wirano/haptic-knob/Model/LCD_TP.png

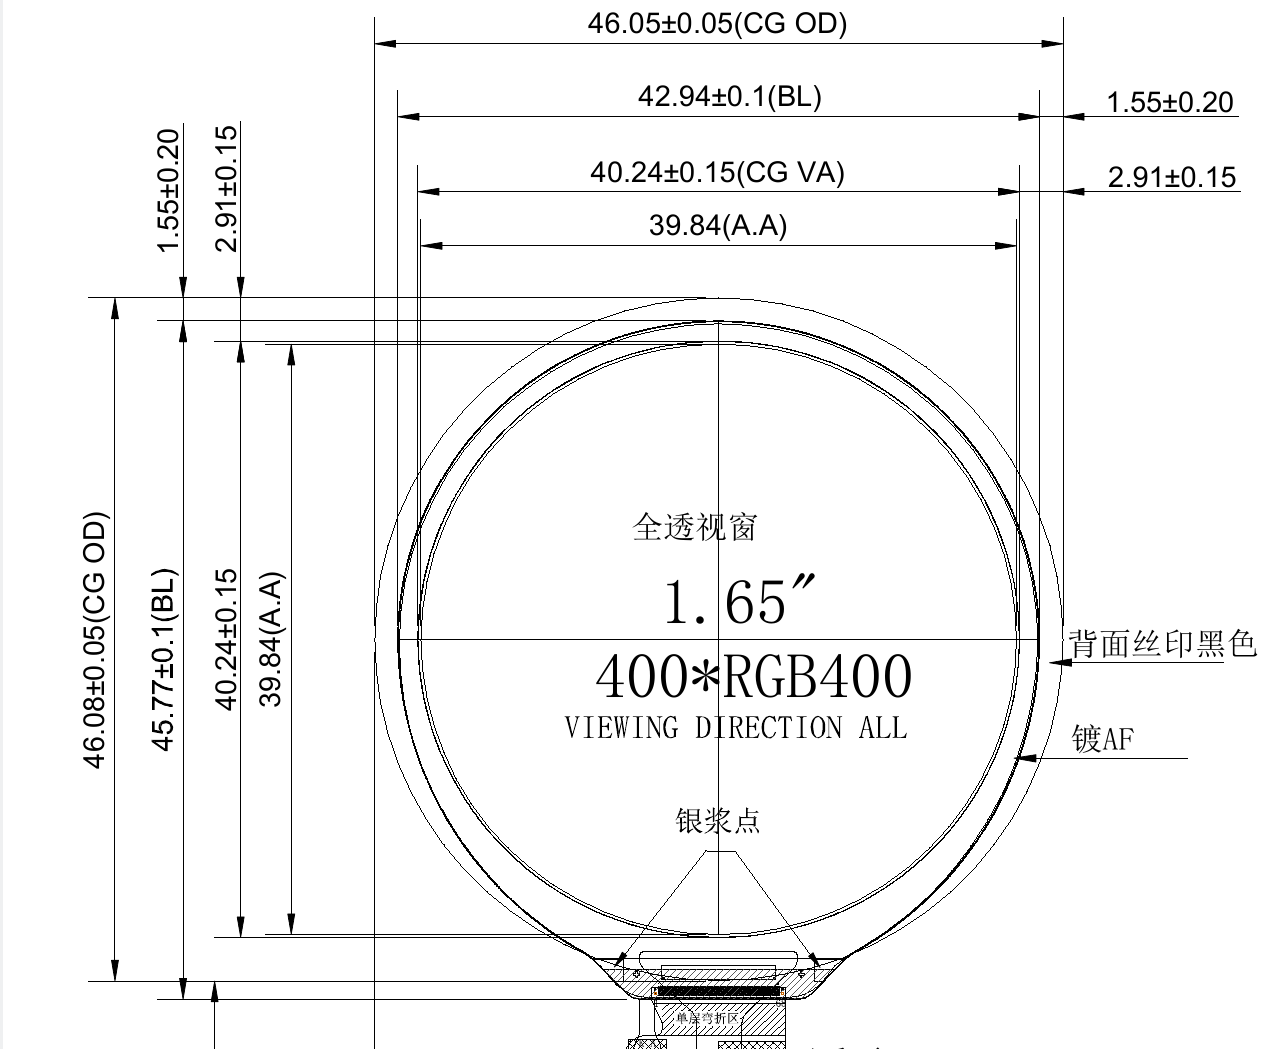
Model/LCD_TP.png
