wirano/haptic-knob/CAD/LCD_PCB_outline.dxf

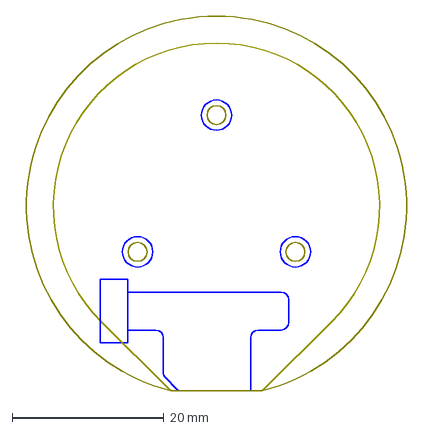
[picture p25: CAD file, 2023-04-01]
CAD/LCD_PCB_outline.dxf
52.7 x 49.3 mm
