wirano/haptic-knob/Hardware/knob_LCD/3dmodules/x1002wrs-14e-lpswhf.stp

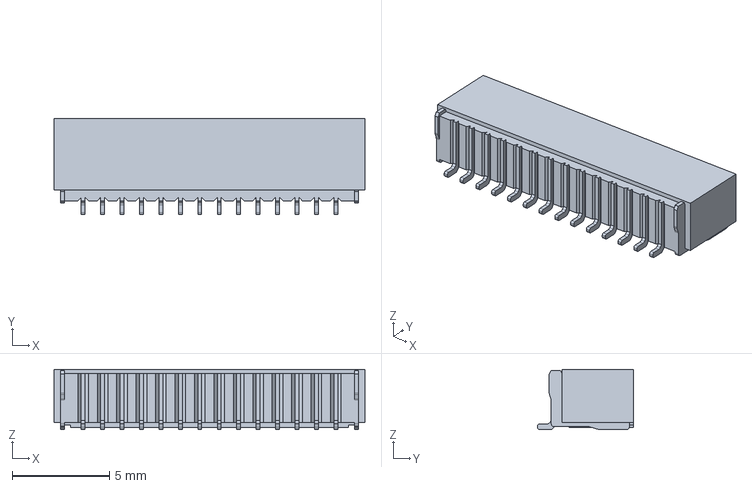
[picture p26: CAD file, 2023-04-01]
Hardware/knob_LCD/3dmodules/x1002wrs-14e-lpswhf.stp
16.0 x 4.95 x 3.10 mm
