wirano/haptic-knob/Hardware/knob_motherboard/3dmodels/u262-16xn-4bvc11.stp

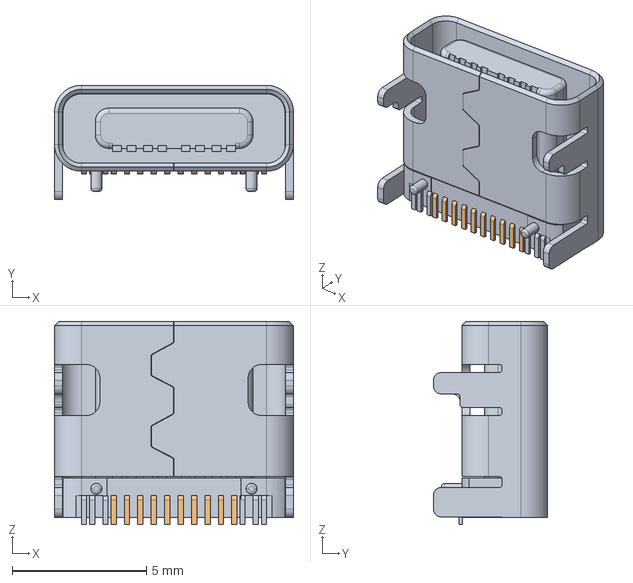
[picture p27: CAD file, 2023-04-01]
Hardware/knob_motherboard/3dmodels/u262-16xn-4bvc11.stp
8.90 x 4.26 x 7.56 mm
