wirano/haptic-knob/Model/knob_LCD.FCStd

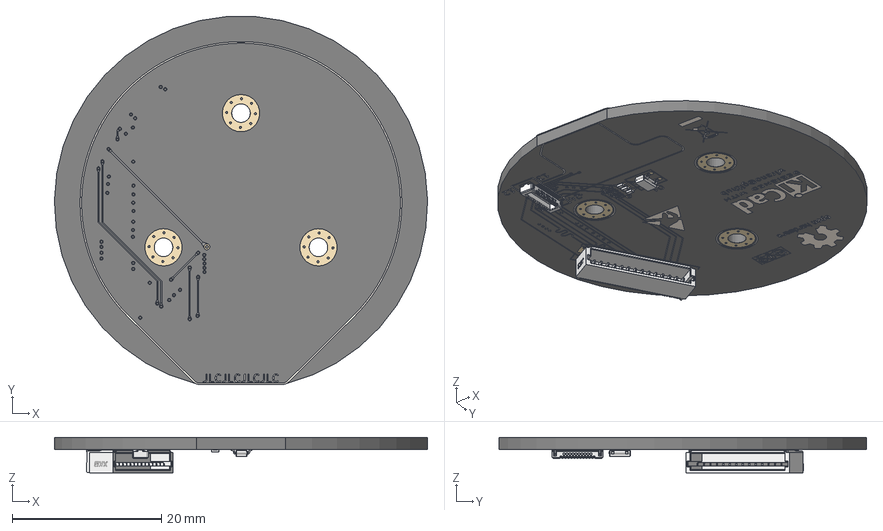
[picture p28: CAD file, 2023-04-01]
Model/knob_LCD.FCStd
50.1 x 49.4 x 4.80 mm
Pcb_8407
topPads_8407
topTracks_8407
topZones_8407
botPads_8407
botTracks_8407
botZones_8407
botSilks_4c08
topSilks_41dc
R2_R_0402_1005Metric_26de13cdf996 x 3
J3_X1002WRS-14E-LPSWHF_e18f2537ddf7
Q1_TSOT_23_52eeb46e2703
