wirano/haptic-knob/CAD/motherboard_outline.dxf

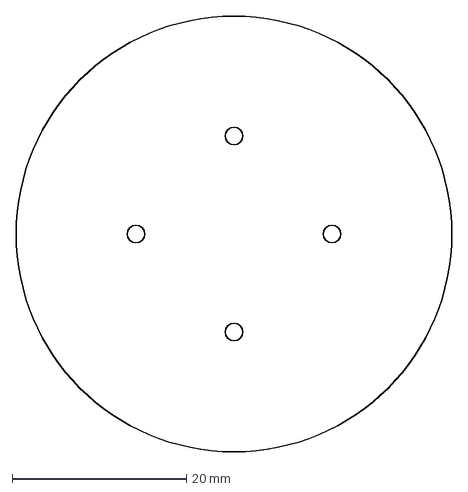
[picture p29: CAD file, 2023-04-01]
CAD/motherboard_outline.dxf
50.0 x 50.0 mm
