wirano/haptic-knob/Model/motor_adapter.FCStd

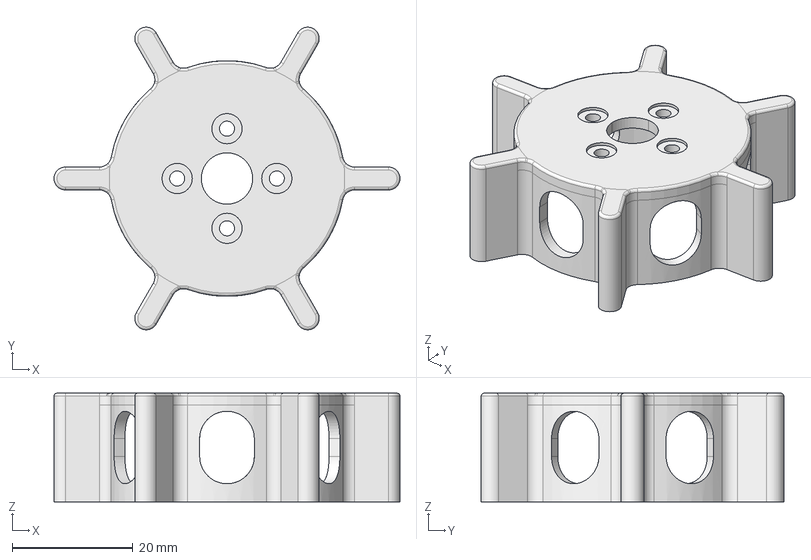
[picture p30: CAD file, 2023-04-01]
Model/motor_adapter.FCStd
57.3 x 50.1 x 18.0 mm
