wirano/haptic-knob/Model/motor_base.FCStd

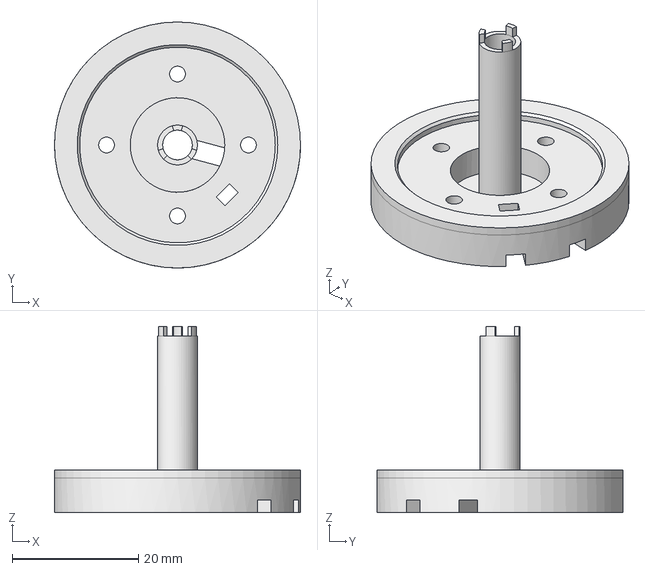
[picture p31: CAD file, 2023-04-01]
Model/motor_base.FCStd
39.0 x 39.0 x 29.5 mm
