wirano/haptic-knob/Hardware/knob_motherboard/3dmodels/Sensirion_Humidity_SHT3x_STEP-file.STEP

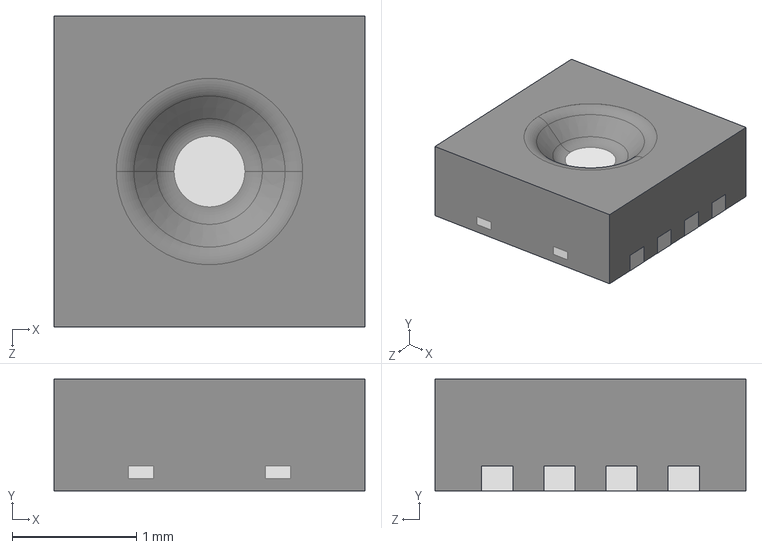
[picture p32: CAD file, 2023-04-01]
Hardware/knob_motherboard/3dmodels/Sensirion_Humidity_SHT3x_STEP-file.STEP
2.50 x 0.901 x 2.50 mm
