wirano/haptic-knob/Model/LCD_TP.FCStd

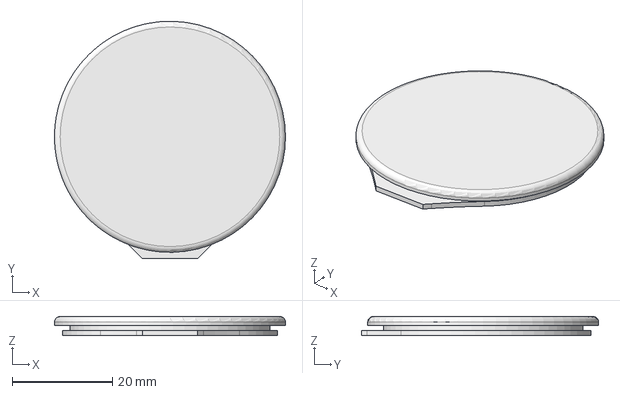
[picture p33: CAD file, 2023-04-01]
Model/LCD_TP.FCStd
46.0 x 47.3 x 3.80 mm
