wirano/haptic-knob/Hardware/knob_motherboard/3dmodels/RRW0024A.stp

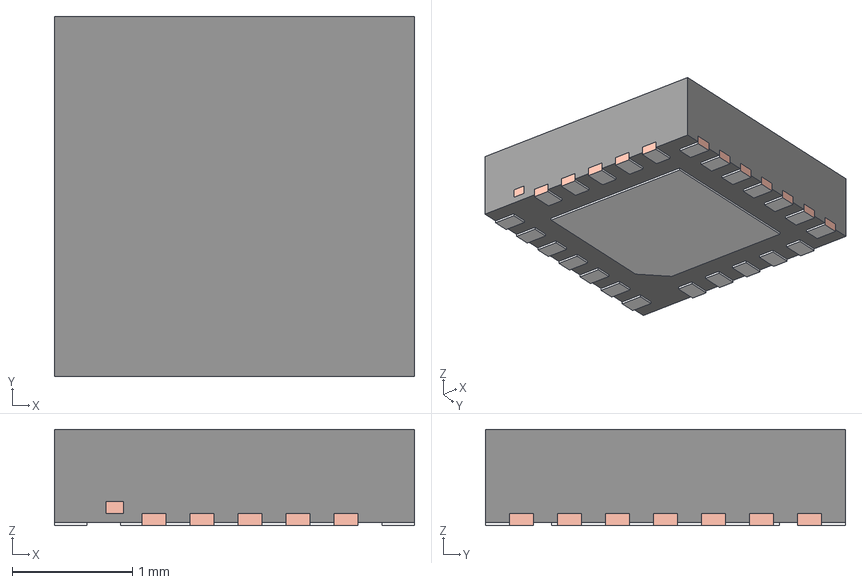
[picture p34: CAD file, 2023-04-01]
Hardware/knob_motherboard/3dmodels/RRW0024A.stp
3.00 x 3.00 x 0.8 mm
BODY-QFN
FRAME-RRW0024A
PIN1-ID
