wirano/haptic-knob/Model/knob_motherboard.FCStd

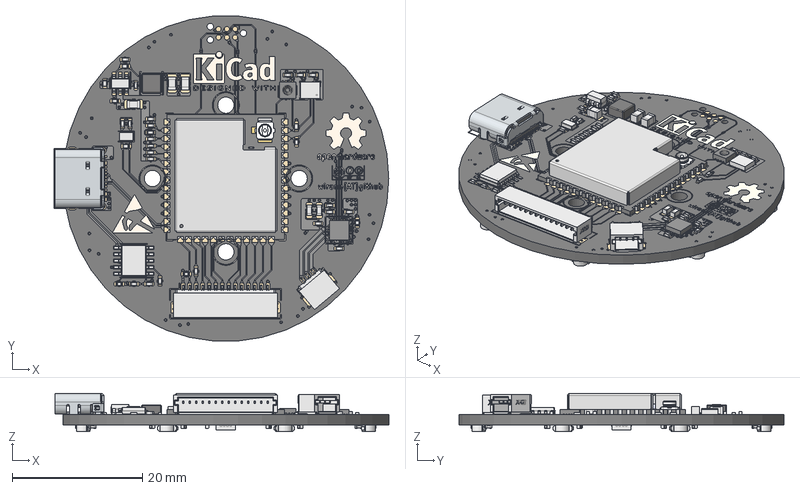
[picture p35: CAD file, 2023-04-01]
Model/knob_motherboard.FCStd
51.3 x 49.9 x 5.84 mm
Pcb_9057
topPads_9057
topTracks_9057
topZones_9057
botPads_9057
botTracks_9057
botZones_9057
botSilks_b501
topSilks_b8d5
U5_LGA_14_3x25mm_P05mm_LayoutBorder3x4y_0628d36b5890
C27_C_0402_1005Metric_14388a46943a x 28
R11_R_0402_1005Metric_5bd5d940f457 x 13
U4_SSOP_10_39x49mm_P100mm_ab08d24b988a
U6_SOT_23_6_54bf529284e4
C29_C_0805_2012Metric_c5b85da9672d x 3
Y1_MicroCrystal_CC8V_T1A_78db1a4d791b
629722000214_Housing
629722000214_Pin1_Top
629722000214_Pin4_Bottom
629722000214_Pin4_Top
629722000214_Pin1_Bottom
629722000214_Pin3_Bottom
629722000214_Pin3_Top
629722000214_Pin2_Top
629722000214_Pin2_Bottom
629722000214_Pin1_Top_mir
629722000214_Pin1_Bottom_mir
629722000214_Pin2_Top_mir
629722000214_Pin2_Bottom_mir
629722000214_Pin3_Top_mir
629722000214_Pin3_Bottom_mir
629722000214_Pin4_Top001
629722000214_Pin4_Bottom_mir
629722000214_Shielding2
629722000214_Shielding
BODY-QFN
FRAME-RRW0024A
FRAME-RRW0024A001
FRAME-RRW0024A002
FRAME-RRW0024A003
FRAME-RRW0024A004
FRAME-RRW0024A005
FRAME-RRW0024A006
FRAME-RRW0024A007
FRAME-RRW0024A008
FRAME-RRW0024A009
FRAME-RRW0024A010
FRAME-RRW0024A011
FRAME-RRW0024A012
FRAME-RRW0024A013
FRAME-RRW0024A014
FRAME-RRW0024A015
FRAME-RRW0024A016
FRAME-RRW0024A017
FRAME-RRW0024A018
FRAME-RRW0024A019
FRAME-RRW0024A020
FRAME-RRW0024A021
FRAME-RRW0024A022
FRAME-RRW0024A023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
