wirano/haptic-knob/Hardware/knob_motherboard/3dmodels/x1002wrs-03e-lpswhf.stp

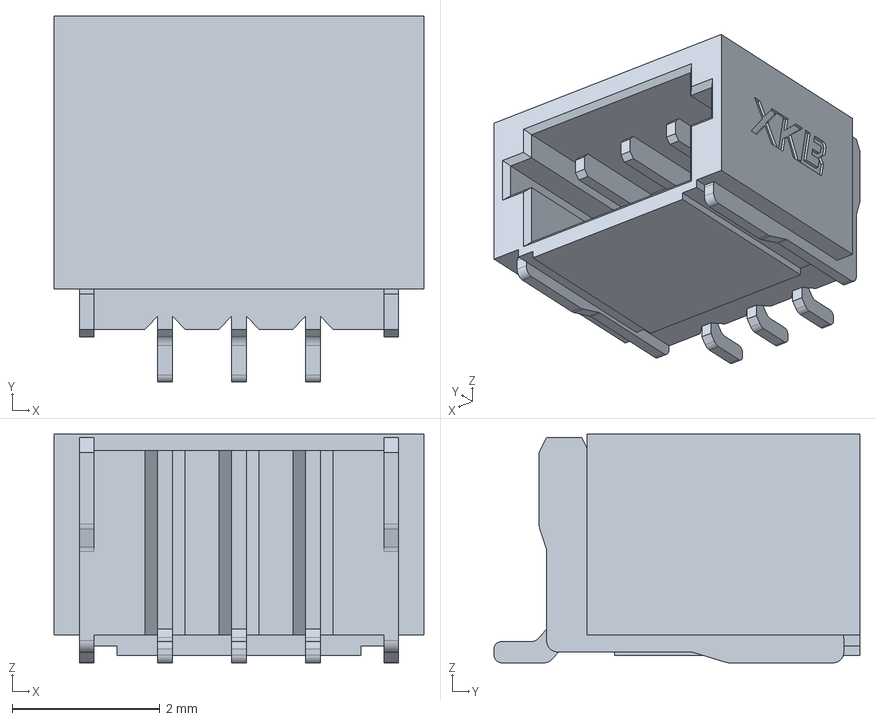
[picture p36: CAD file, 2023-04-01]
Hardware/knob_motherboard/3dmodels/x1002wrs-03e-lpswhf.stp
5.00 x 4.95 x 3.10 mm
