wirano/haptic-knob/Model/shell_bottom.FCStd

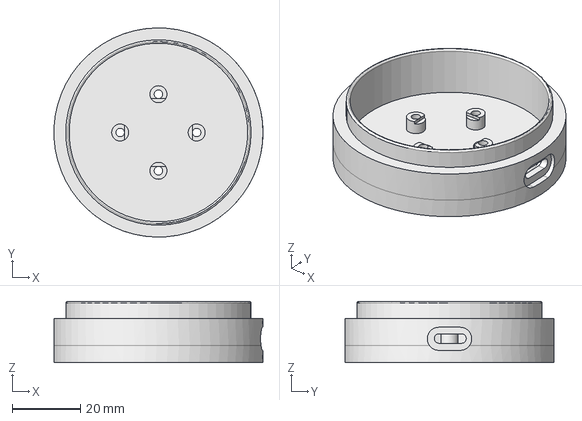
[picture p37: CAD file, 2023-04-01]
Model/shell_bottom.FCStd
61.5 x 61.5 x 18.0 mm
