wirano/haptic-knob/Model/BLDC_2804.FCStd

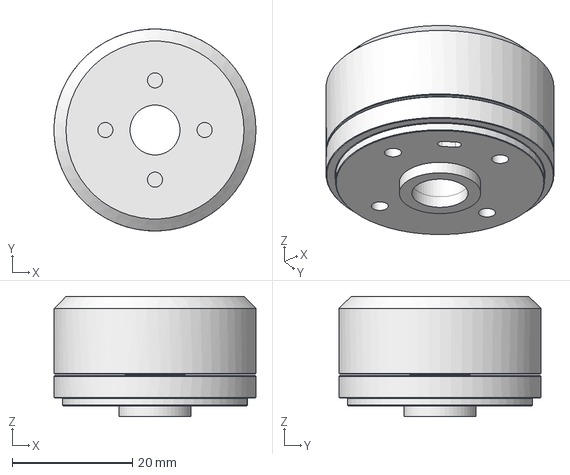
[picture p38: CAD file, 2023-04-01]
Model/BLDC_2804.FCStd
33.6 x 33.6 x 20.0 mm
