wirano/haptic-knob/Model/motor2804.STEP

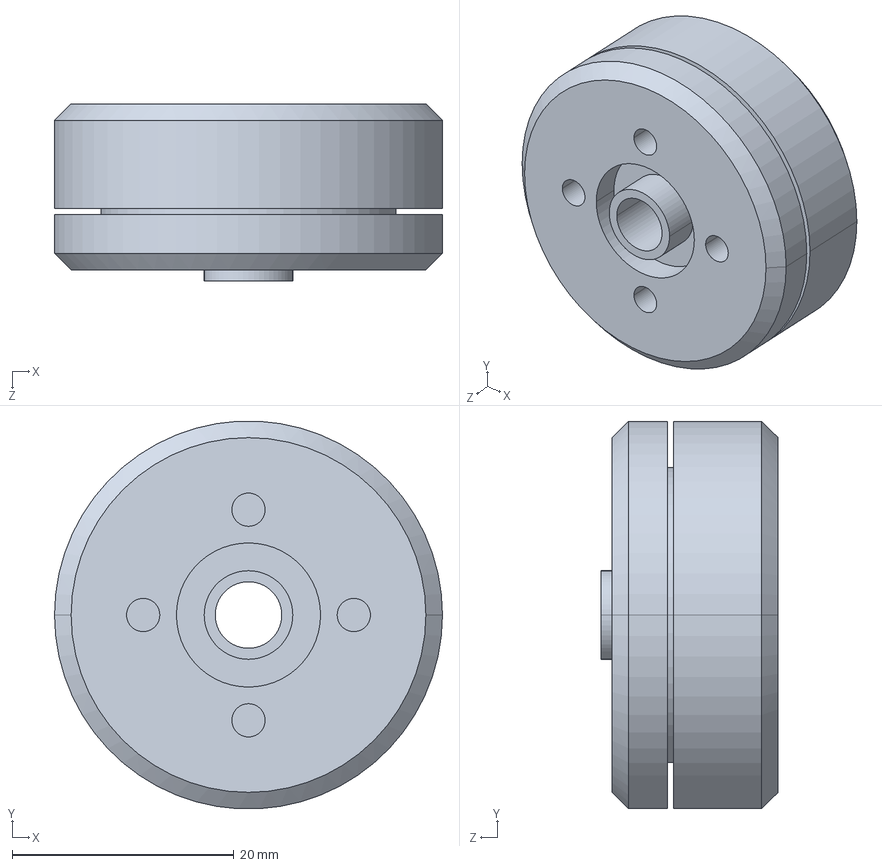
[picture p39: CAD file, 2023-04-01]
Model/motor2804.STEP
35.0 x 34.9 x 16.0 mm
