wirano/haptic-knob/Model/panel_base.FCStd

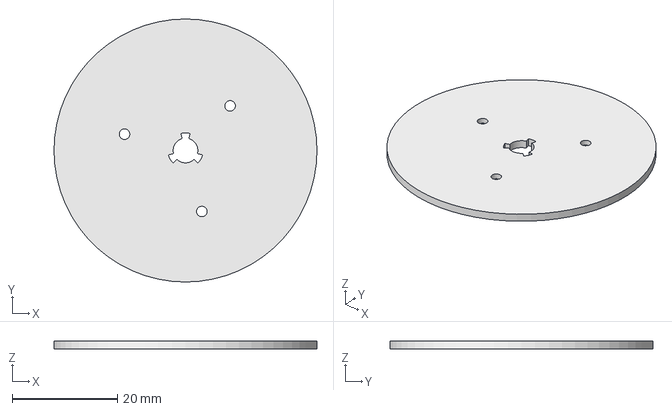
[picture p40: CAD file, 2023-04-01]
Model/panel_base.FCStd
50.0 x 50.0 x 1.50 mm
