wirano/haptic-knob/Model/encoder_magnet.FCStd

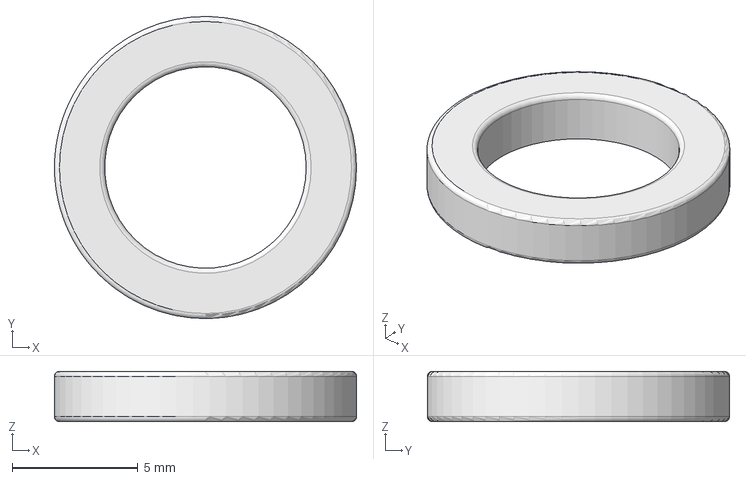
[picture p41: CAD file, 2023-04-01]
Model/encoder_magnet.FCStd
12.0 x 12.0 x 2.00 mm
