wirano/haptic-knob/Model/shell_up.FCStd

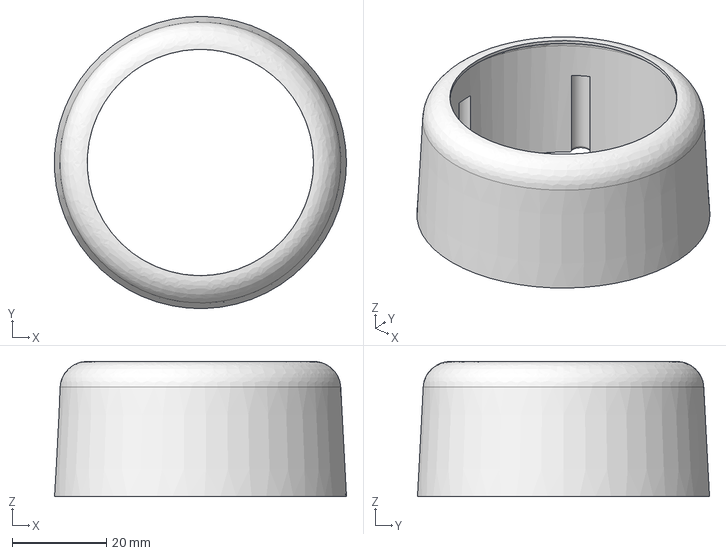
[picture p42: CAD file, 2023-04-01]
Model/shell_up.FCStd
62.0 x 62.0 x 28.7 mm
