wirano/haptic-knob/Model/LCD.FCStd

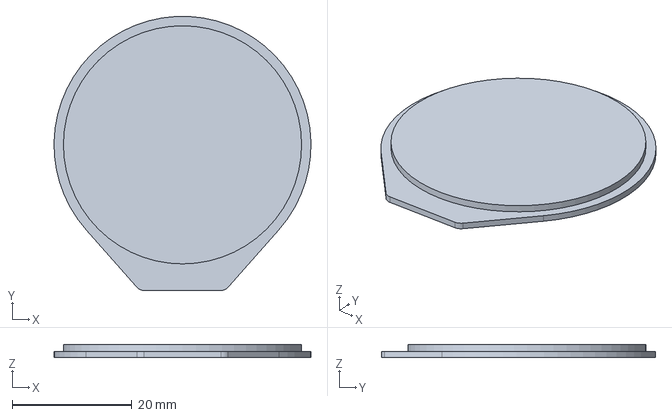
[picture p43: CAD file, 2023-04-01]
Model/LCD.FCStd
43.0 x 45.8 x 2.11 mm
