wirano/haptic-knob/(list of files, cad)

Other CAD files:
Model/knob_motherboard.step.FCStd
Hardware/knob_LCD/3dmodules/55909-2474.stp
