wirano/haptic-knob/Hardware/knob_LCD/knob_LCD.kicad_pcb

## KiCad design Hardware/knob_LCD/knob_LCD.kicad_pcb (2023-04-13)

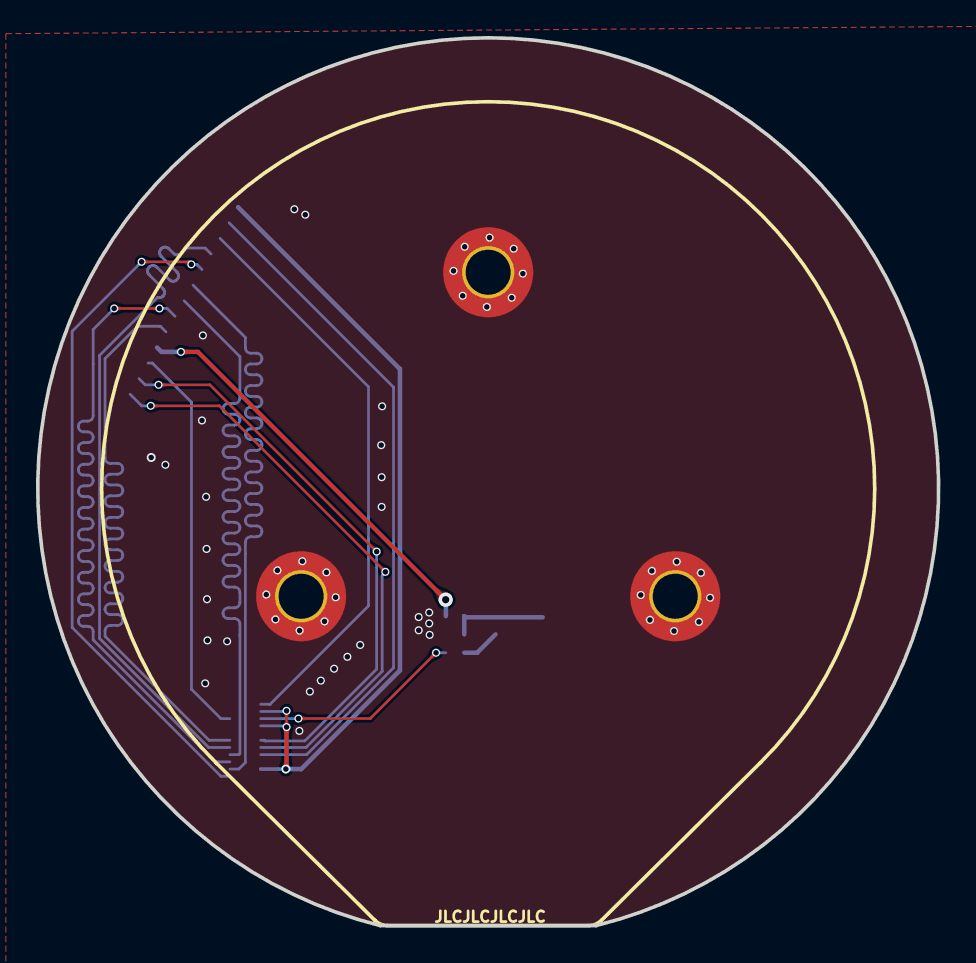
[picture p49: board knob_LCD.kicad_pcb from above]

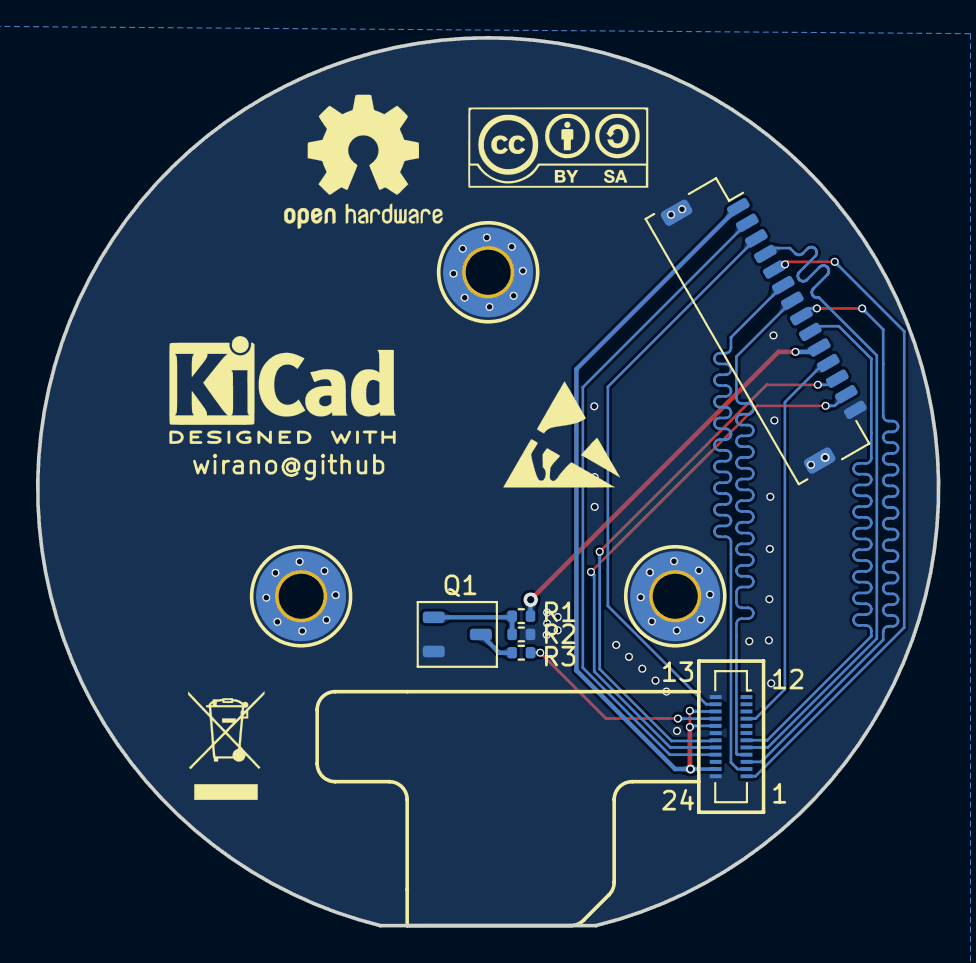
[picture p50: board knob_LCD.kicad_pcb from below]

Board: 2 copper layers, 50.0 x 49.3 mm, 9 parts (6 on the bottom side), 17 nets.

Parts:
H1, H2, H3: MountingHole_Pad; MountingHole_2.5mm_Pad_TopBottom
J1: ST77903; Molex_SlimStack_502430-2410_2x12_P0.40mm_Vertical
J3: Conn_01x14_Socket; JST_SHL_SM14B-SHLS-TF_1x14-1MP_P1.00mm_Horizontal
Q1: AO3400A; TSOT-23
R1: 100R; R_0402_1005Metric
R2: 10K; R_0402_1005Metric
R3: 10R; R_0402_1005Metric

Connections:
+3V3: J1.15 (VCC), J1.17 (LEDA), J1.23 (TP_VDD), J3.1
/LCD_BLK: J3.10, R1.1
/LCD_CLK: J1.4 (CLK), J3.7
/LCD_CS: J1.1 (CS), J3.5
/LCD_D0: J1.2 (IO0), J3.6
/LCD_D1: J1.3 (IO1), J3.8
/LCD_D2: J1.6 (IO2), J3.9
/LCD_D3: J1.5 (IO3), J3.4
/LCD_RST: J1.9 (RST), J3.11
/LCD_TE: J1.14 (TE), J3.3
/LEDK: J1.16 (LEDK), R3.1
/TP_RST: J1.21 (TP_RST), J3.2
/TP_SCL: J1.19 (TP_SCL), J3.12
/TP_SDA: J1.20 (TP_SDA), J3.13
GND: H1.1, H2.1, H3.1, J1.13 (GND), J1.18 (GND), J1.24 (GND), J3.14, J3.MP, Q1.2 (S), R2.2
unnamed: Q1.3 (D), R3.2
unnamed: Q1.1 (G), R1.2, R2.1
