wirano/haptic-knob/Hardware/knob_motherboard/haptic-knob.kicad_pcb

## KiCad design Hardware/knob_motherboard/haptic-knob.kicad_pcb (2023-04-13)

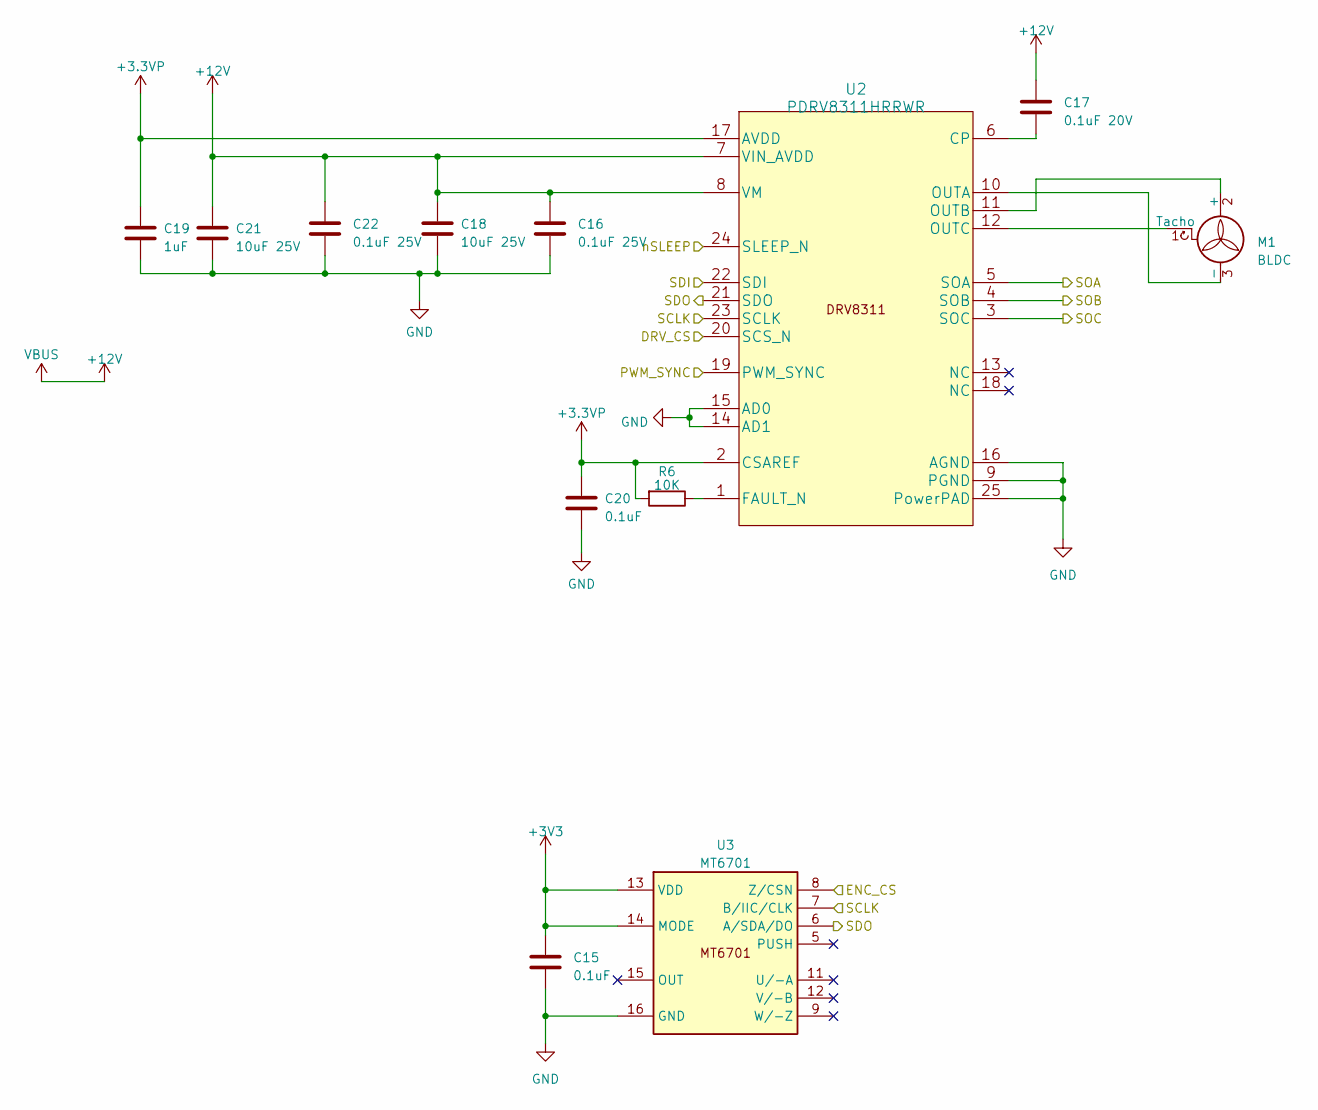
[picture p51: schematic BLDC.kicad_sch, haptic-knob]

Parts:
C15, C20: 0.1uF; C_0402_1005Metric
C16, C22: 0.1uF 25V; C_0402_1005Metric
C17: 0.1uF 20V; C_0402_1005Metric
C18, C21: 10uF 25V; C_0603_1608Metric
C19: 1uF; C_0402_1005Metric
M1: BLDC; JST_SH_BM03B-SRSS-TB_1x03-1MP_P1.00mm_Vertical
R6: 10K; R_0402_1005Metric
U2: PDRV8311HRRWR
U3: MT6701; QFN-16-1EP_3x3mm_P0.5mm_EP1.7x1.7mm

Connections:
+3.3VP: C19.1, C20.1, R6.2, U2.2 (CSAREF), U2.17 (AVDD)
+3V3: C15.1, U3.13 (VDD), U3.14 (MODE); also elsewhere on the board
+12V: C16.1, C17.1, C18.1, C21.1, C22.1, U2.7 (VIN_AVDD), U2.8 (VM); also elsewhere on the board
/BLDC/DRV_CS: U2.20 (SCS_N); also elsewhere on the board
/BLDC/ENC_CS: U3.8 (Z/CSN); also elsewhere on the board
/BLDC/PWM_SYNC: U2.19 (PWM_SYNC); also elsewhere on the board
/BLDC/SCLK: U2.23 (SCLK), U3.7 (B/IIC/CLK); also elsewhere on the board
/BLDC/SDI: U2.22 (SDI); also elsewhere on the board
/BLDC/SDO: U2.21 (SDO), U3.6 (A/SDA/DO); also elsewhere on the board
/BLDC/nSLEEP: U2.24 (SLEEP_N); also elsewhere on the board
/Core/SOA: U2.5 (SOA); also elsewhere on the board
/Core/SOB: U2.4 (SOB); also elsewhere on the board
/Core/SOC: U2.3 (SOC); also elsewhere on the board
GND: C15.2, C16.2, C18.2, C19.2, C20.2, C21.2, C22.2, M1.MP, U2.9 (PGND), U2.14 (AD1), U2.15 (AD0), U2.16 (AGND), U2.25 (PowerPAD), U2.26, U2.27, U2.28, U2.29, U2.30, U3.16 (GND), U3.17; also elsewhere on the board
unnamed: M1.2 (+), U2.11 (OUTB)
unnamed: M1.3 (-), U2.10 (OUTA)
unnamed: M1.1 (Tacho), U2.12 (OUTC)
unnamed: C17.2, U2.6 (CP)
unnamed: R6.1, U2.1 (FAULT_N)

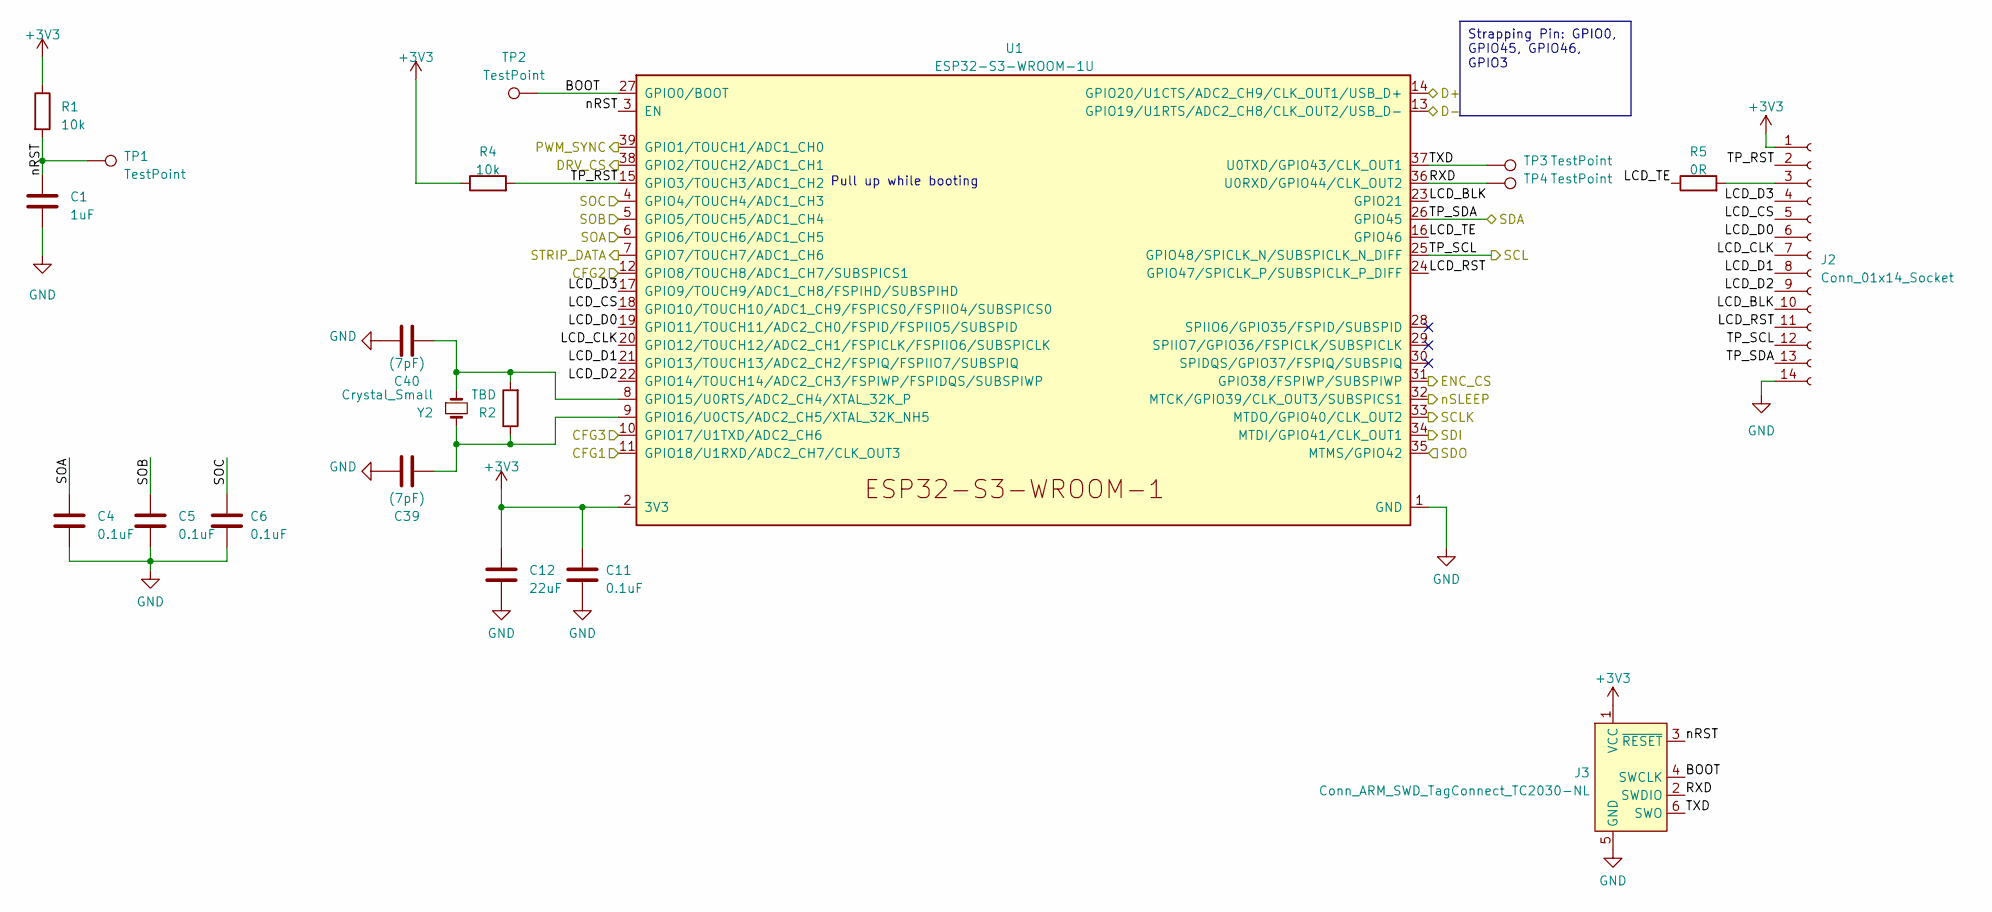
[picture p52: schematic Core.kicad_sch, haptic-knob]

Parts:
C1: 1uF; C_0402_1005Metric
C4, C5, C6, C11: 0.1uF; C_0402_1005Metric
C12: 22uF; C_0402_1005Metric
C39, C40: (7pF); C_0402_1005Metric
J2: Conn_01x14_Socket; JST_SHL_SM14B-SHLS-TF_1x14-1MP_P1.00mm_Horizontal
J3: Conn_ARM_SWD_TagConnect_TC2030-NL; Tag-Connect_TC2030-IDC-NL_2x03_P1.27mm_Vertical
R1, R4: 10k; R_0402_1005Metric
R2: TBD; R_0402_1005Metric
R5: 0R; R_0402_1005Metric
TP1, TP2, TP3, TP4: TestPoint; TestPoint_Pad_D1.5mm
U1: ESP32-S3-WROOM-1U
Y2: Crystal_Small; Crystal_SMD_2012-2Pin_2.0x1.2mm

Connections:
+3V3: C11.1, C12.1, J2.1, J3.1 (VCC), R1.1, R4.1, U1.2 (3V3); also elsewhere on the board
/BLDC/DRV_CS: U1.38 (GPIO2/TOUCH2/ADC1_CH1); also elsewhere on the board
/BLDC/ENC_CS: U1.31 (GPIO38/FSPIWP/SUBSPIWP); also elsewhere on the board
/BLDC/PWM_SYNC: U1.39 (GPIO1/TOUCH1/ADC1_CH0); also elsewhere on the board
/BLDC/SCLK: U1.33 (MTDO/GPIO40/CLK_OUT2); also elsewhere on the board
/BLDC/SDI: U1.34 (MTDI/GPIO41/CLK_OUT1); also elsewhere on the board
/BLDC/SDO: U1.35 (MTMS/GPIO42); also elsewhere on the board
/BLDC/nSLEEP: U1.32 (MTCK/GPIO39/CLK_OUT3/SUBSPICS1); also elsewhere on the board
/Core/BOOT: J3.4 (SWCLK), TP2.1, U1.27 (GPIO0/BOOT)
/Core/CFG1: U1.10 (GPIO17/U1TXD/ADC2_CH6); also elsewhere on the board
/Core/CFG2: U1.11 (GPIO18/U1RXD/ADC2_CH7/CLK_OUT3); also elsewhere on the board
/Core/CFG3: U1.12 (GPIO8/TOUCH8/ADC1_CH7/SUBSPICS1); also elsewhere on the board
/Core/D+: U1.14 (GPIO20/U1CTS/ADC2_CH9/CLK_OUT1/USB_D+); also elsewhere on the board
/Core/D-: U1.13 (GPIO19/U1RTS/ADC2_CH8/CLK_OUT2/USB_D-); also elsewhere on the board
/Core/LCD_BLK: J2.10, U1.23 (GPIO21)
/Core/LCD_CLK: J2.7, U1.20 (GPIO12/TOUCH12/ADC2_CH1/FSPICLK/FSPIIO6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)
/Core/LCD_CS: J2.5, U1.18 (GPIO10/TOUCH10/ADC1_CH9/FSPICS0/FSPIIO4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)
/Core/LCD_D0: J2.6, U1.19 (GPIO11/TOUCH11/ADC2_CH0/FSPID/FSPIIO5/S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)
/Core/LCD_D1: J2.8, U1.21 (GPIO13/TOUCH13/ADC2_CH2/FSPIQ/FSPIIO7/S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)
/Core/LCD_D2: J2.9, U1.22 (GPIO14/TOUCH14/ADC2_CH3/FSPIWP/FSPIDQS/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)
/Core/LCD_D3: J2.4, U1.17 (GPIO9/TOUCH9/ADC1_CH8/FSPIHD/SUBSPIHD)
/Core/LCD_RST: J2.11, U1.24 (GPIO47/SPICLK_P/SUBSPICLK_P_DIFF)
/Core/LCD_TE: R5.1, U1.16 (GPIO46)
/Core/RXD: J3.2 (SWDIO), TP4.1, U1.36 (U0RXD/GPIO44/CLK_OUT2)
/Core/SOA: C4.1, U1.6 (GPIO6/TOUCH6/ADC1_CH5); also elsewhere on the board
/Core/SOB: C5.1, U1.5 (GPIO5/TOUCH5/ADC1_CH4); also elsewhere on the board
/Core/SOC: C6.1, U1.4 (GPIO4/TOUCH4/ADC1_CH3); also elsewhere on the board
/Core/STRIP_DATA: U1.7 (GPIO7/TOUCH7/ADC1_CH6); also elsewhere on the board
/Core/TP_RST: J2.2, R4.2, U1.15 (GPIO3/TOUCH3/ADC1_CH2)
/Core/TP_SCL: J2.12, U1.25 (GPIO48/SPICLK_N/SUBSPICLK_N_DIFF); also elsewhere on the board
/Core/TP_SDA: J2.13, U1.26 (GPIO45); also elsewhere on the board
/Core/TXD: J3.6 (SWO), TP3.1, U1.37 (U0TXD/GPIO43/CLK_OUT1)
/Core/nRST: C1.1, J3.3 (~RESET), R1.2, TP1.1, U1.3 (EN)
GND: C1.2, C4.2, C5.2, C6.2, C11.2, C12.2, J2.14, J2.MP, J3.5 (GND), U1.1 (GND), U1.40 (GND), U1.41 (GND); also elsewhere on the board
unnamed: J2.3, R5.2
unnamed 49: R2.2, U1.8 (GPIO15/U0RTS/ADC2_CH4/XTAL_32K_P); also elsewhere on the board
unnamed 50: R2.1, U1.9 (GPIO16/U0CTS/ADC2_CH5/XTAL_32K_NH5); also elsewhere on the board

Notes on the sheet:
Strapping Pin: GPIO0, GPIO45, GPIO46, GPIO3
Pull up while booting

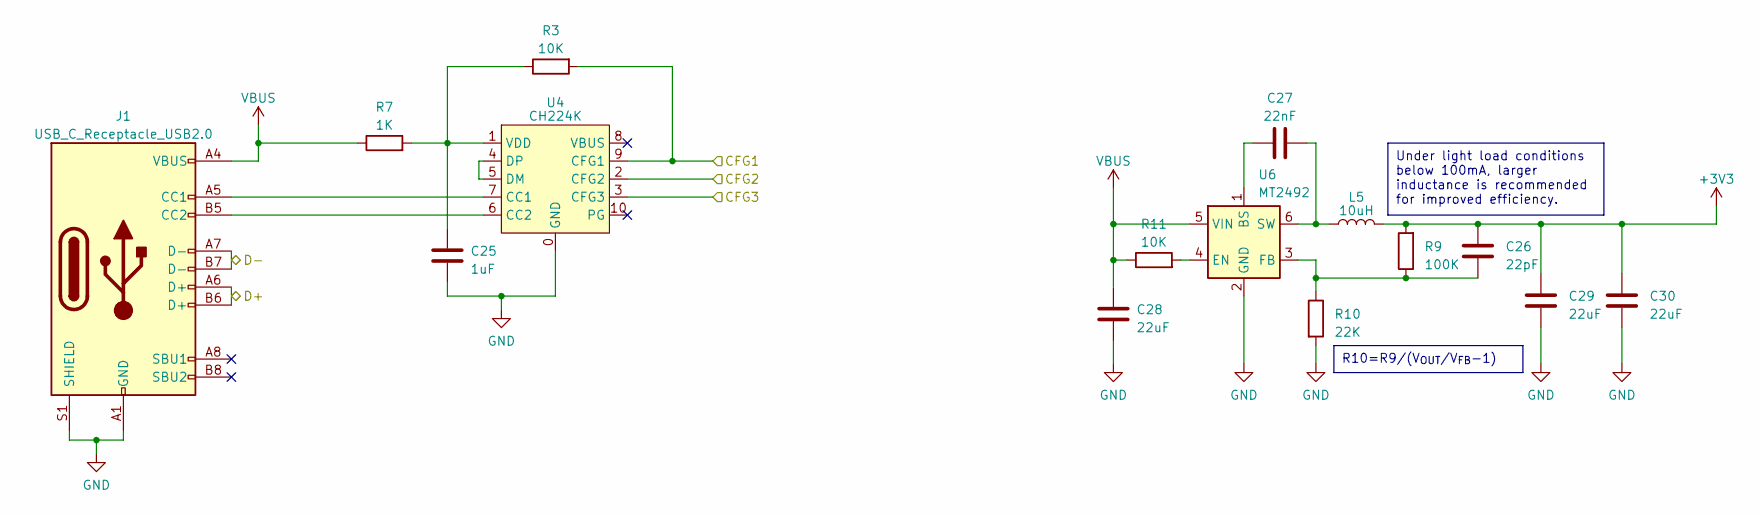
[picture p53: schematic Power.kicad_sch, haptic-knob]

Parts:
C25: 1uF; C_0402_1005Metric
C26: 22pF; C_0402_1005Metric
C27: 22nF; C_0402_1005Metric
C28, C29, C30: 22uF; C_0805_2012Metric
J1: USB_C_Receptacle_USB2.0; USB_C_Receptacle_XKB_U262-16XN-4BVC11
L5: 10uH; L_Sunlord_SWPA3015S
R3, R11: 10K; R_0402_1005Metric
R7: 1K; R_0402_1005Metric
R9: 100K; R_0402_1005Metric
R10: 22K; R_0402_1005Metric
U4: CH224K; ESSOP-10_3.9x4.9mm_P1.00mm_EP2.3x3.2mm
U6: MT2492; SOT-23-6

Connections:
+3V3: C26.2, C29.1, C30.1, L5.2, R9.2; also elsewhere on the board
+12V: C28.1, J1.A4 (VBUS), J1.A9 (VBUS), J1.B4 (VBUS), J1.B9 (VBUS), R7.1, R11.1, U6.5 (VIN); also elsewhere on the board
/Core/CFG1: R3.2, U4.9 (CFG1); also elsewhere on the board
/Core/CFG2: U4.2 (CFG2); also elsewhere on the board
/Core/CFG3: U4.3 (CFG3); also elsewhere on the board
/Core/D+: J1.A6 (D+), J1.B6 (D+); also elsewhere on the board
/Core/D-: J1.A7 (D-), J1.B7 (D-); also elsewhere on the board
GND: C25.2, C28.2, C29.2, C30.2, J1.A1 (GND), J1.A12 (GND), J1.B1 (GND), J1.B12 (GND), J1.S1 (SHIELD), R10.2, U4.0 (GND), U6.2 (GND); also elsewhere on the board
unnamed: J1.A5 (CC1), U4.7 (CC1)
unnamed: J1.B5 (CC2), U4.6 (CC2)
unnamed: U4.4 (DP), U4.5 (DM)
unnamed: C25.1, R3.1, R7.2, U4.1 (VDD)
unnamed: C27.1, U6.1 (BS)
unnamed: R11.2, U6.4 (EN)
unnamed: C26.1, R9.1, R10.1, U6.3 (FB)
unnamed: C27.2, L5.1, U6.6 (SW)

Notes on the sheet:
R10=R9/(V_{OUT}/V_{FB}-1)
Under light load conditions below 100mA, larger inductance is recommended for improved efficiency.

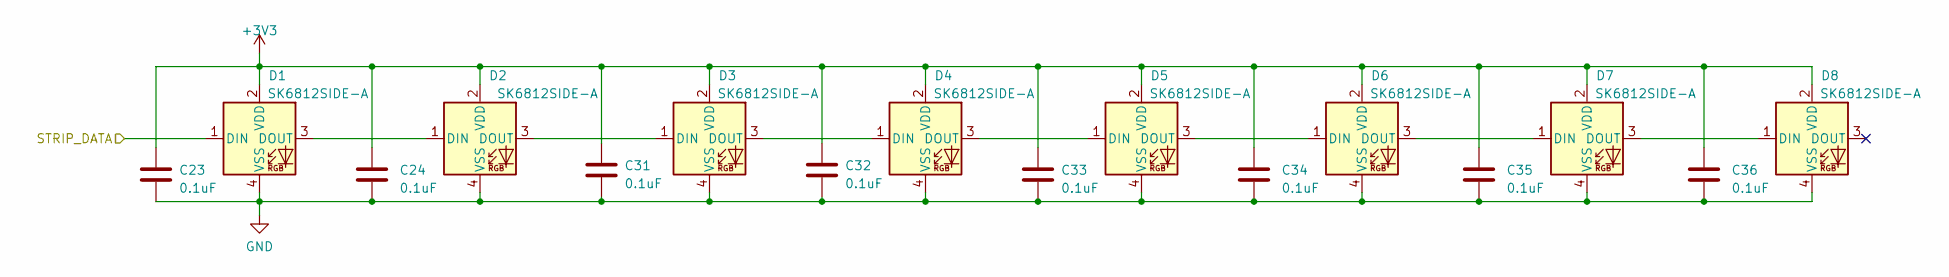
[picture p54: schematic Strip.kicad_sch, haptic-knob]

Parts:
C23, C24, C31, C32, C33, C34, C35, C36: 0.1uF; C_0402_1005Metric
D1, D2, D3, D4, D5, D6, D7, D8: SK6812SIDE-A; SK6812D-EC3210R

Connections:
+3V3: C23.1, C24.1, C31.1, C32.1, C33.1, C34.1, C35.1, C36.1, D1.2 (VDD), D2.2 (VDD), D3.2 (VDD), D4.2 (VDD), D5.2 (VDD), D6.2 (VDD), D7.2 (VDD), D8.2 (VDD); also elsewhere on the board
/Core/STRIP_DATA: D1.1 (DIN); also elsewhere on the board
GND: C23.2, C24.2, C31.2, C32.2, C33.2, C34.2, C35.2, C36.2, D1.4 (VSS), D2.4 (VSS), D3.4 (VSS), D4.4 (VSS), D5.4 (VSS), D6.4 (VSS), D7.4 (VSS), D8.4 (VSS); also elsewhere on the board
unnamed: D1.3 (DOUT), D2.1 (DIN)
unnamed: D2.3 (DOUT), D3.1 (DIN)
unnamed: D3.3 (DOUT), D4.1 (DIN)
unnamed: D4.3 (DOUT), D5.1 (DIN)
unnamed: D5.3 (DOUT), D6.1 (DIN)
unnamed: D6.3 (DOUT), D7.1 (DIN)
unnamed: D7.3 (DOUT), D8.1 (DIN)

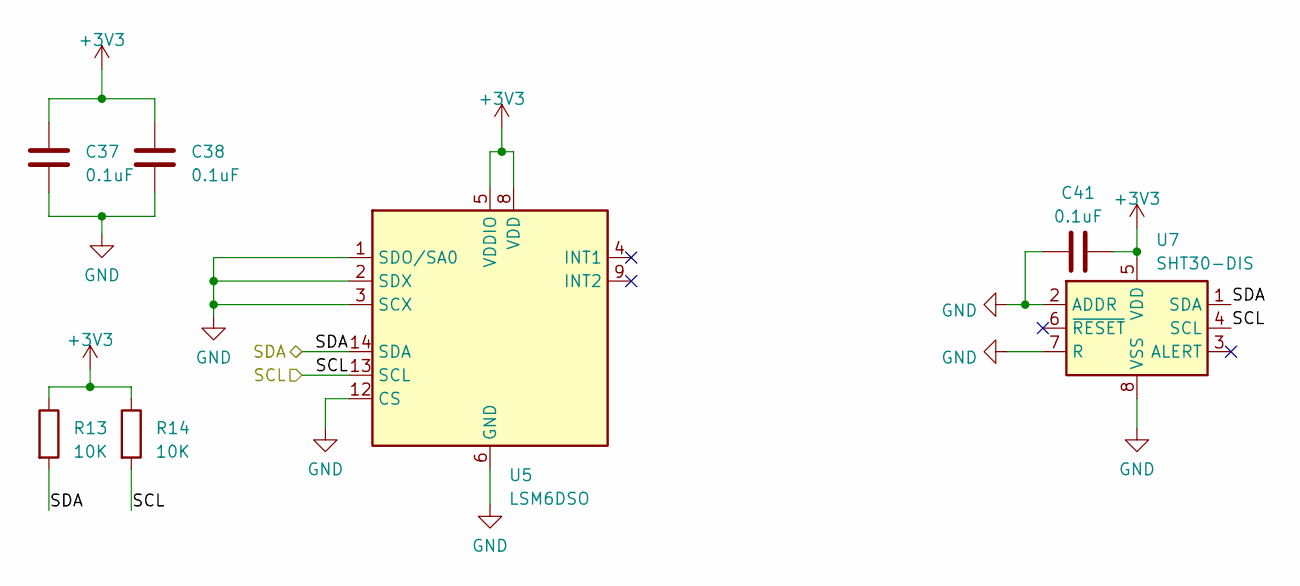
[picture p55: schematic Sensor.kicad_sch, haptic-knob]

Parts:
C37, C38, C41: 0.1uF; C_0402_1005Metric
R13, R14: 10K; R_0402_1005Metric
U5: LSM6DSO; LGA-14_3x2.5mm_P0.5mm_LayoutBorder3x4y
U7: SHT30-DIS; Sensirion_DFN-8-1EP_2.5x2.5mm_P0.5mm_EP1.1x1.7mm

Connections:
+3V3: C37.1, C38.1, C41.2, R13.1, R14.1, U5.5 (VDDIO), U5.8 (VDD), U7.5 (VDD); also elsewhere on the board
/Core/TP_SCL: R14.2, U5.13 (SCL), U7.4 (SCL); also elsewhere on the board
/Core/TP_SDA: R13.2, U5.14 (SDA), U7.1 (SDA); also elsewhere on the board
GND: C37.2, C38.2, C41.1, U5.1 (SDO/SA0), U5.2 (SDX), U5.3 (SCX), U5.6 (GND), U5.7 (GND), U5.12 (CS), U7.2 (ADDR), U7.7 (R), U7.8 (VSS), U7.9 (VSS); also elsewhere on the board

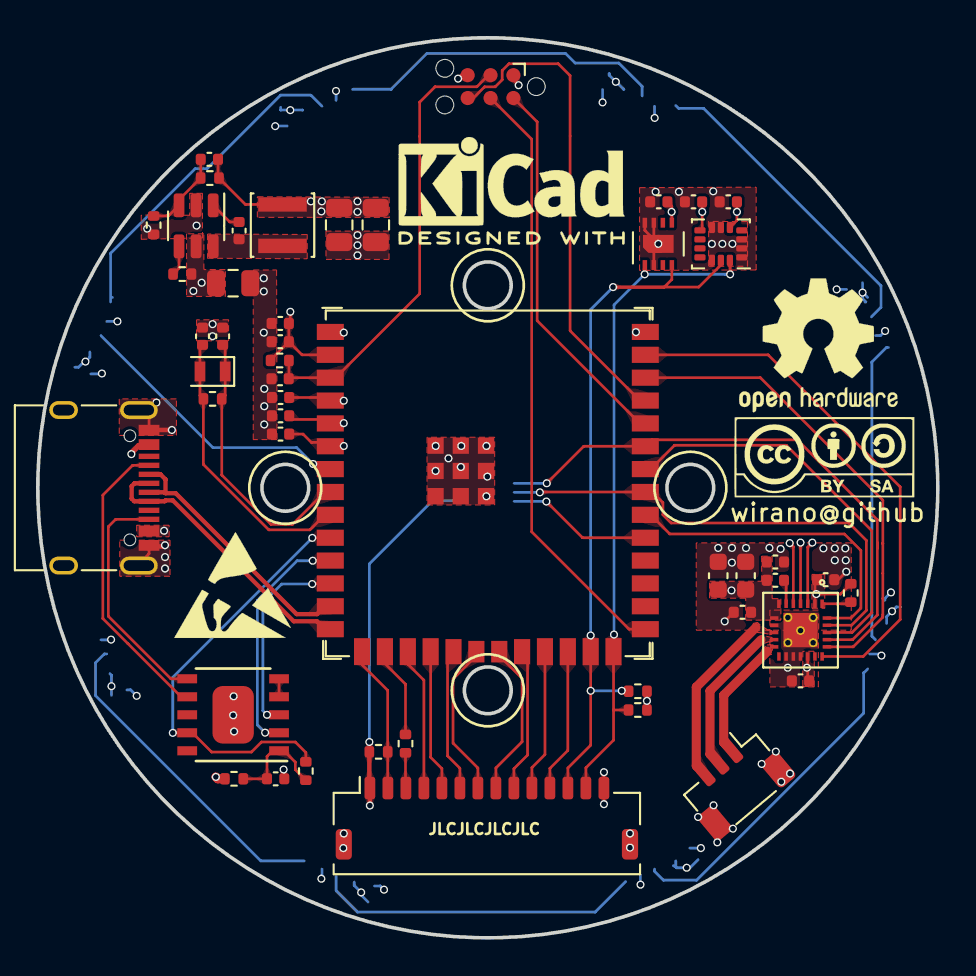
[picture p56: board haptic-knob.kicad_pcb from above]

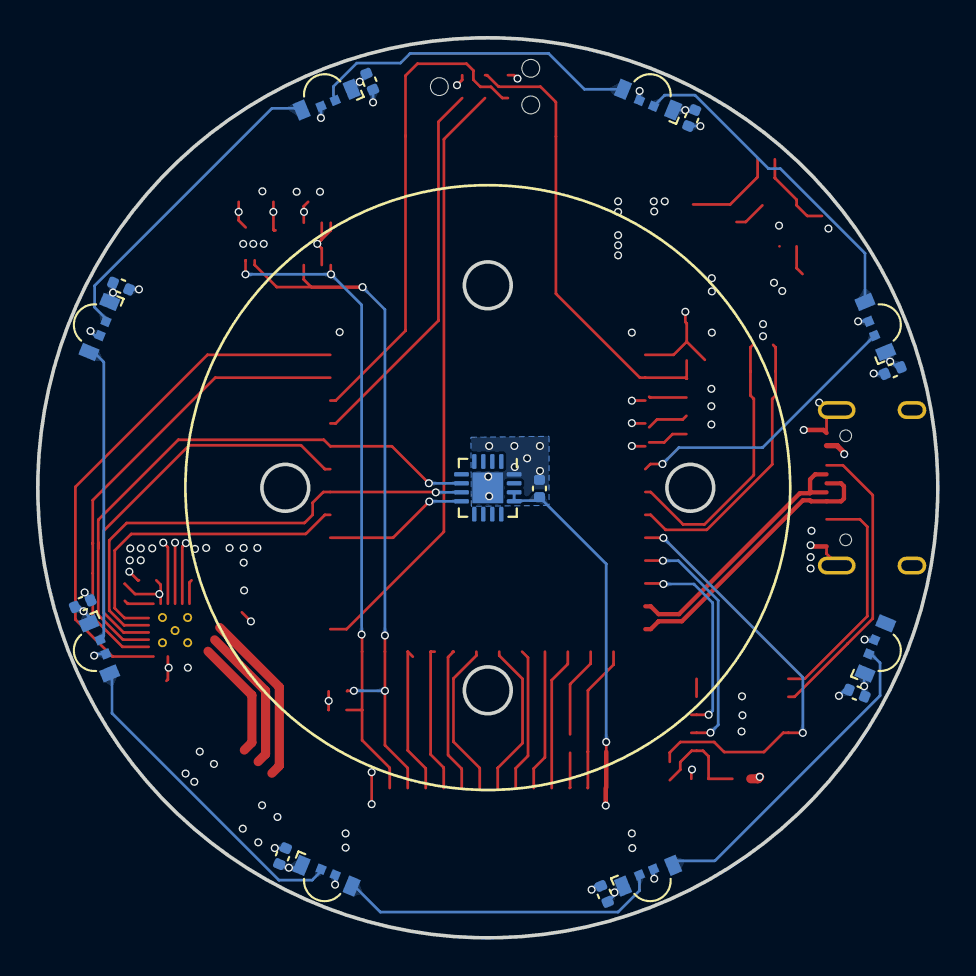
[picture p57: board haptic-knob.kicad_pcb from below]

Board: 4 copper layers, 50.0 x 50.0 mm, 66 parts (18 on the bottom side), 59 nets.

Other parts of the board:
C2, C3: (7pF); C_0402_1005Metric
Y1: Crystal_Small; Crystal_SMD_2012-2Pin_2.0x1.2mm

Their connections:
GND: C2.2, C3.2; also elsewhere on the board
unnamed 49: C3.1, Y1.1; also elsewhere on the board
unnamed 50: C2.1, Y1.2; also elsewhere on the board
