wirano/haptic-knob/Firmware/haptic-knob/main/haptic-knob.c

#include "driver/gpio.h"
#include "esp_log.h"
#include "freertos/FreeRTOS.h"
#include "freertos/task.h"
#include "nvs_flash.h"

#include "lv_port.h"
#include "knob_task.h"
#include "wifi.h"
#include "mqtt.h"

#define CFG1    17U
#define CFG2    18U
#define CFG3    8U

#define TAG "main"

void app_main(void) {
    gpio_config_t gpio_conf;

    gpio_conf.mode = GPIO_MODE_OUTPUT;
    gpio_conf.intr_type = GPIO_INTR_DISABLE;
    gpio_conf.pull_up_en = false;
    gpio_conf.pull_down_en = false;
    gpio_conf.pin_bit_mask = 1 << CFG1;
    gpio_config(&gpio_conf);

    gpio_conf.pin_bit_mask = 1 << CFG2;
    gpio_config(&gpio_conf);

    gpio_conf.pin_bit_mask = 1 << CFG3;
    gpio_config(&gpio_conf);

    // 12V
    gpio_set_level(CFG2, 0);
    gpio_set_level(CFG3, 1);
    gpio_set_level(CFG1, 0);

    nvs_flash_init();

//    wifi_init_sta();

//    mqtt_app_start();

    lvgl_init();

    knob_task_init();

    vTaskDelete(NULL);
}
