wirano/haptic-knob/Firmware/haptic-knob/components/lv_port/lv_port_disp.c

/**
 * @file lv_port_disp_templ.c
 *
 */


/*********************
 *      INCLUDES
 *********************/
#include "lv_port_disp.h"
#include "st77903_driver.h"
#include "freertos/FreeRTOS.h"
#include "freertos/task.h"
#include "esp_log.h"

/*********************
 *      DEFINES
 *********************/
#define MY_DISP_HOR_RES        400
#define MY_DISP_VER_RES        400


#define LCD_PIN_CS      10
#define LCD_PIN_CLK     12
#define LCD_PIN_D0      11
#define LCD_PIN_D1      13
#define LCD_PIN_D2      14
#define LCD_PIN_D3      9

#define LCD_PIN_RST     47
#define LCD_PIN_BLK     21

#ifndef MY_DISP_HOR_RES
#warning Please define or replace the macro MY_DISP_HOR_RES with the actual screen width, default value 320 is used for now.
#define MY_DISP_HOR_RES    320
#endif

#ifndef MY_DISP_VER_RES
#warning Please define or replace the macro MY_DISP_HOR_RES with the actual screen height, default value 240 is used for now.
#define MY_DISP_VER_RES    240
#endif

#define TAG "lv_port_disp"

EXT_RAM_BSS_ATTR lv_color_t buf_1[MY_DISP_HOR_RES * MY_DISP_HOR_RES];
EXT_RAM_BSS_ATTR lv_color_t buf_2[MY_DISP_HOR_RES * MY_DISP_HOR_RES];

static void disp_init(void);

static void disp_flush(lv_disp_drv_t *disp_drv, const lv_area_t *area, lv_color_t *color_p);

void lv_port_disp_init(void) {
    disp_init();

    /* Example for 2) */
    static lv_disp_draw_buf_t draw_buf_dsc;
    lv_disp_draw_buf_init(&draw_buf_dsc, buf_1, buf_2,
                          MY_DISP_HOR_RES * MY_DISP_HOR_RES);   /*Initialize the display buffer*/

    /*-----------------------------------
     * Register the display in LVGL
     *----------------------------------*/

    static lv_disp_drv_t disp_drv;                         /*Descriptor of a display driver*/
    lv_disp_drv_init(&disp_drv);                    /*Basic initialization*/

    /*Set up the functions to access to your display*/

    /*Set the resolution of the display*/
    disp_drv.hor_res = MY_DISP_HOR_RES;
    disp_drv.ver_res = MY_DISP_VER_RES;

    /*Used to copy the buffer's content to the display*/
    disp_drv.flush_cb = disp_flush;

    /*Set a display buffer*/
    disp_drv.draw_buf = &draw_buf_dsc;

    disp_drv.full_refresh = 1;

    /*Finally register the driver*/
    lv_disp_drv_register(&disp_drv);
}

/**********************
 *   STATIC FUNCTIONS
 **********************/

/*Initialize your display and the required peripherals.*/
static void disp_init(void) {
    st77903_lcd_desc_t lcd = {
            .spi_bus = SPI2_HOST,
            .cs_pin = LCD_PIN_CS,
            .d0_pin = LCD_PIN_D0,
            .d1_pin = LCD_PIN_D1,
            .d2_pin = LCD_PIN_D2,
            .d3_pin = LCD_PIN_D3,
            .spi_freq = 40 * 1000 * 1000,
            .clk_pin = LCD_PIN_CLK,
            .te_pin = -1,
            .bl_pin = LCD_PIN_BLK,
            .bl_timer = -1,
            .rst_pin = LCD_PIN_RST,
            .core_pinned = 1
    };

    lcdqspi_initialize(&lcd);
}

volatile bool disp_flush_enabled = true;

/* Enable updating the screen (the flushing process) when disp_flush() is called by LVGL
 */
void disp_enable_update(void) {
    disp_flush_enabled = true;
}

/* Disable updating the screen (the flushing process) when disp_flush() is called by LVGL
 */
void disp_disable_update(void) {
    disp_flush_enabled = false;
}

/*Flush the content of the internal buffer the specific area on the display
 *You can use DMA or any hardware acceleration to do this operation in the background but
 *'lv_disp_flush_ready()' has to be called when finished.*/
static void disp_flush(lv_disp_drv_t *disp_drv, const lv_area_t *area, lv_color_t *color_p) {
    if (disp_flush_enabled) {
        /*The most simple case (but also the slowest) to put all pixels to the screen one-by-one*/

//        for (uint32_t y = area->y1; y <= area->y2; y++) {
//            lcdqspi_draw_line(area->x1, area->x2, y, (uint32_t *) color_p);
//            color_p = color_p + area->x2 - area->x1 + 1;
//
        ulTaskNotifyTake(pdTRUE,portMAX_DELAY);

        frame_buffer = (uint16_t *)color_p;
    }

    /*IMPORTANT!!!
     *Inform the graphics library that you are ready with the flushing*/
    lv_disp_flush_ready(disp_drv);
}
