wirano/haptic-knob/(commit log)

2023-04-03 modified pin
2023-04-03 fix socket pinout
    [knob_LCD.kicad_pcb, positions.csv]
2023-04-05 drv8311 spi bugfix & ch224k CFG1 bugfix
    [BLDC.kicad_sch, Core.kicad_sch, Power.kicad_sch, bom.csv, designators.csv, haptic-knob.kicad_pcb, haptic-knob.kicad_sch, positions.csv]
2023-04-11 bom export
    [haptic-knob.kicad_pcb]
2023-04-11 CH224K & ST77903 symbol fix
    [BLDC.kicad_sch, Core.kicad_sch, Power.kicad_sch, Sensor.kicad_sch, Strip.kicad_sch, haptic-knob.kicad_pcb, haptic-knob.kicad_sch, knob_LCD.kicad_pcb]
2023-04-12 change pin num
2023-04-14 invert drv8311 transmit package
    [drv8311_driver.c, haptic-knob.c]
2023-04-15 generate MCPWM for PWM SYNC; tuning drv8311 timing
2023-04-18 add pid
2023-04-20 add adc current sample
2023-04-21 make current sense work
2023-05-01 use simpleFOC's pid
2023-05-04 add encoder & ui
2023-05-06 add wifi&mqtt
    [partitions.csv]
2023-05-07 switch to new pid controler
